rustychris/freebird/firmware/sketches/README.md

Sketches
###

Shell01Teensy: this is the primary firmware running on the Teensy.  This is probably all that you need, with the possible exception
of programming the baud rate/name for the bluetooth.  That's handled by a separate sketch which I've not yet gotten around to
posting.
