rustychris/freebird/hardware/batterypack/pcb_batteries-brd.png

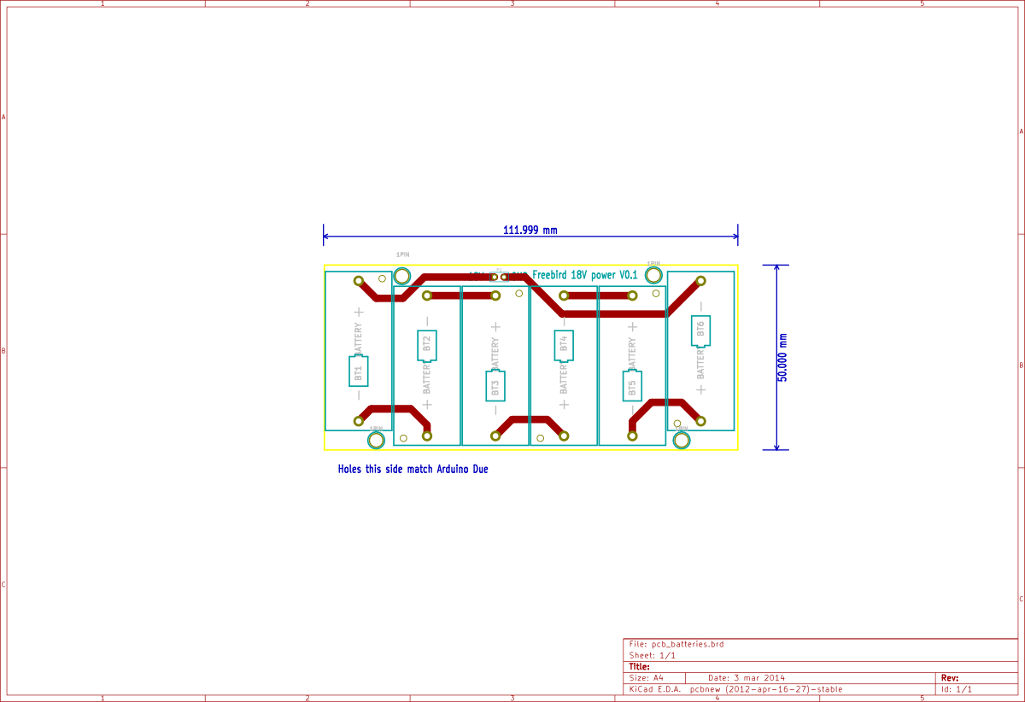
hardware/batterypack/pcb_batteries-brd.png
