rustychris/freebird/hardware/batterypack/pcb_batteries.png

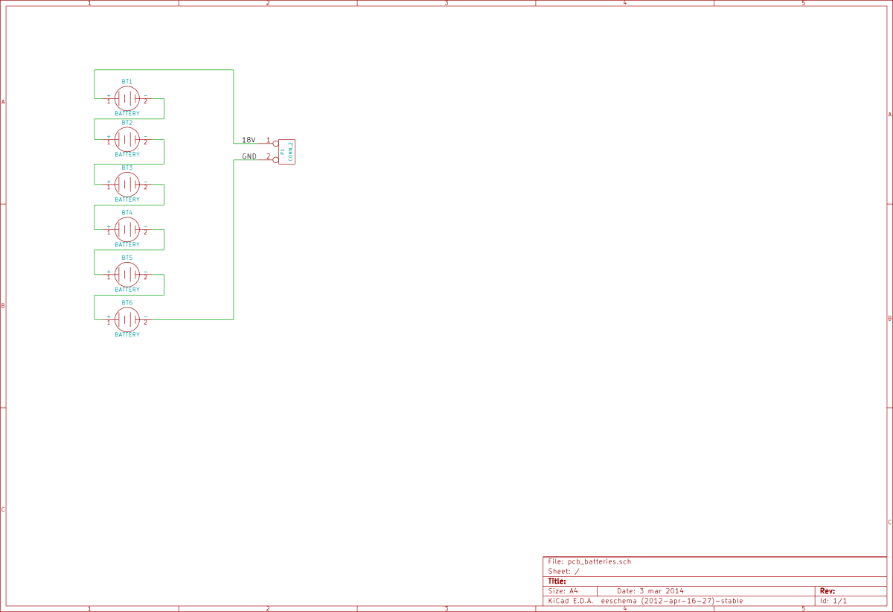
hardware/batterypack/pcb_batteries.png
