rustychris/freebird/hardware/logger/freebird_pcb01-brd.png

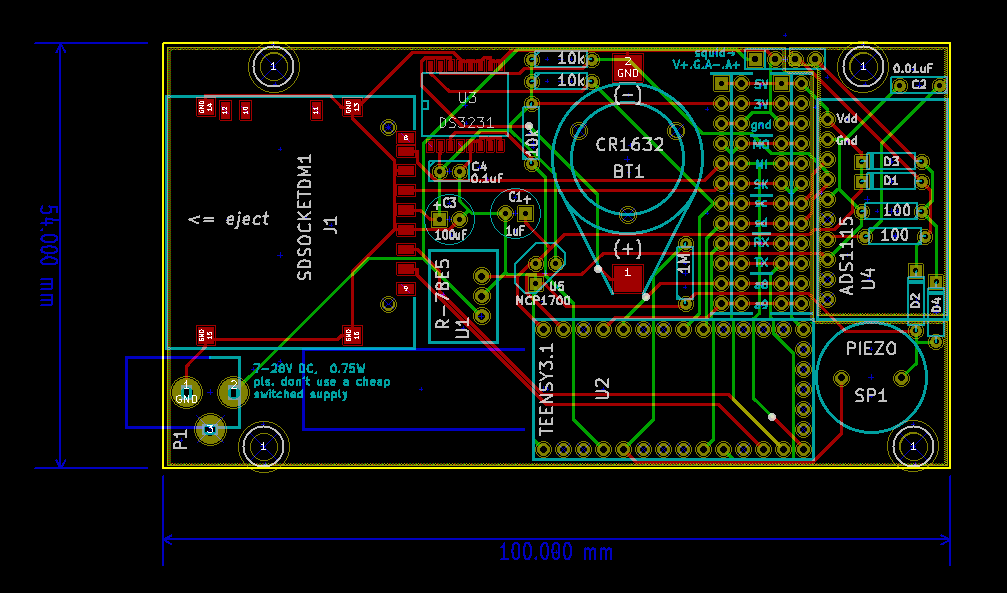
hardware/logger/freebird_pcb01-brd.png
