rustychris/freebird/hardware/logger/freebird_pcb01.png

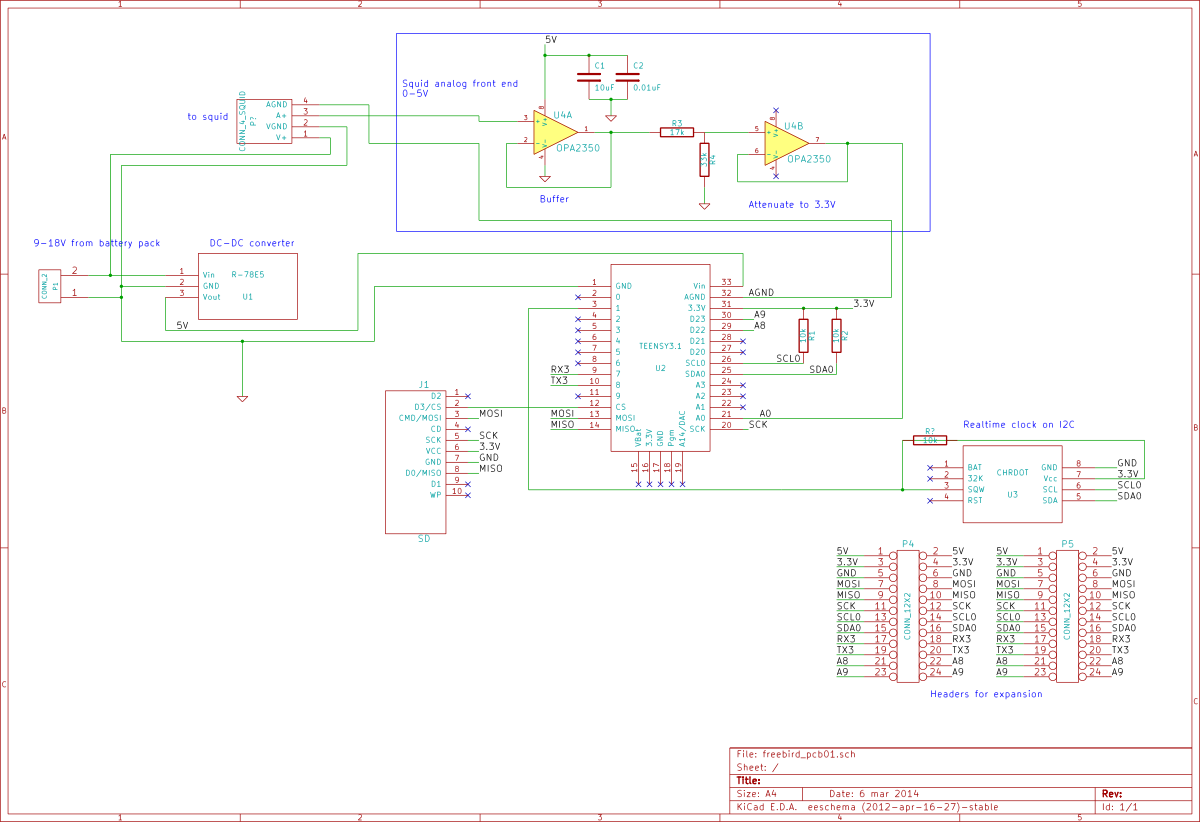
hardware/logger/freebird_pcb01.png
