rustychris/freebird/hardware/logger/freebird_pcb01.pdf

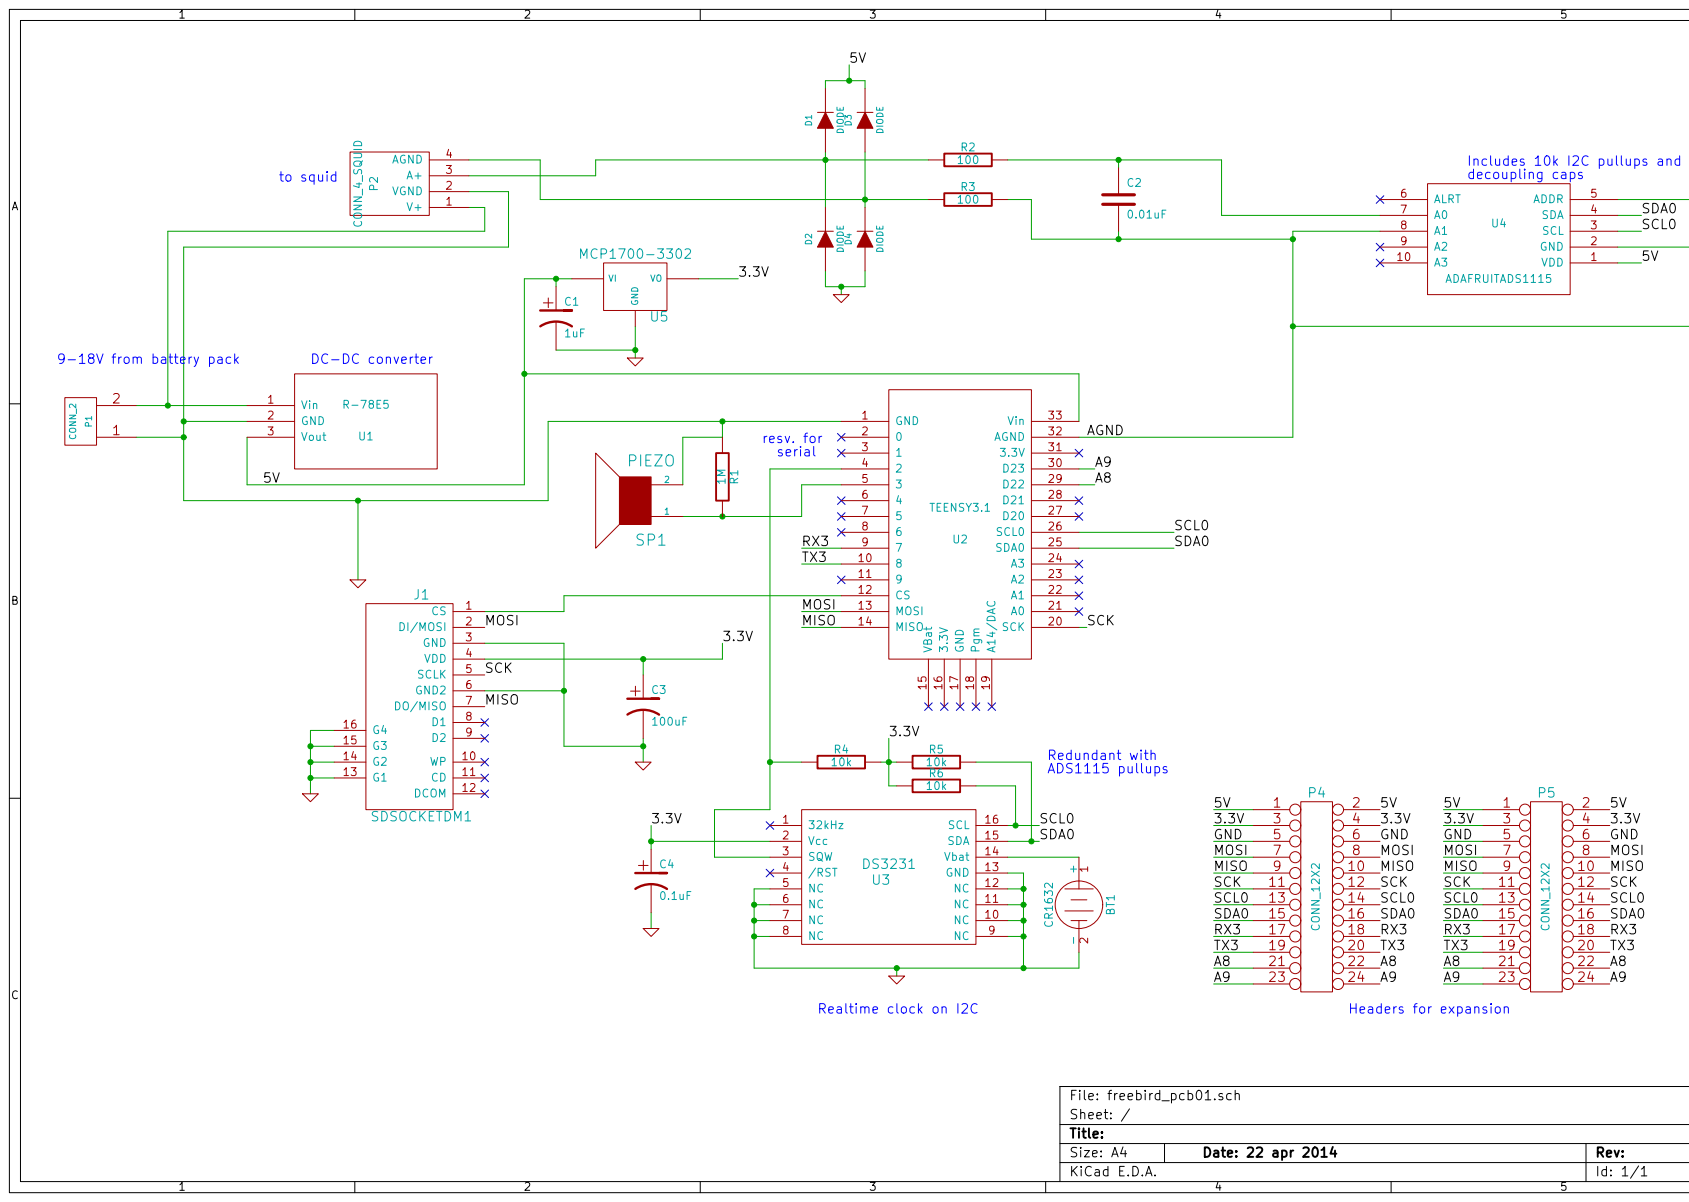
[picture p5: page 1]
