rustychris/freebird/hardware/batterypack/pcb_batteries-brd.pdf

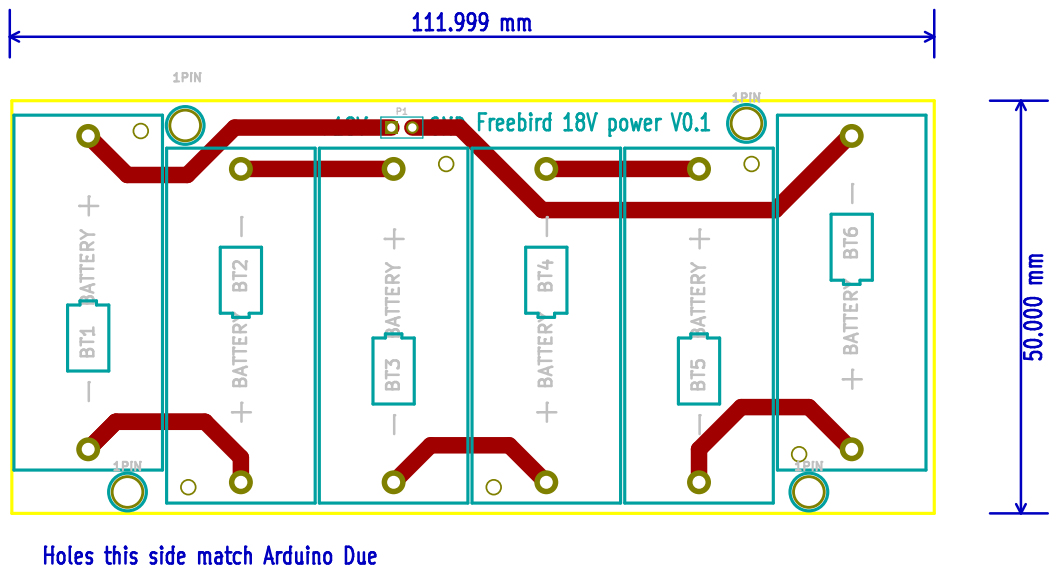
[picture p6: page 1]
