rustychris/freebird/hardware/batterypack/pcb_batteries.pdf

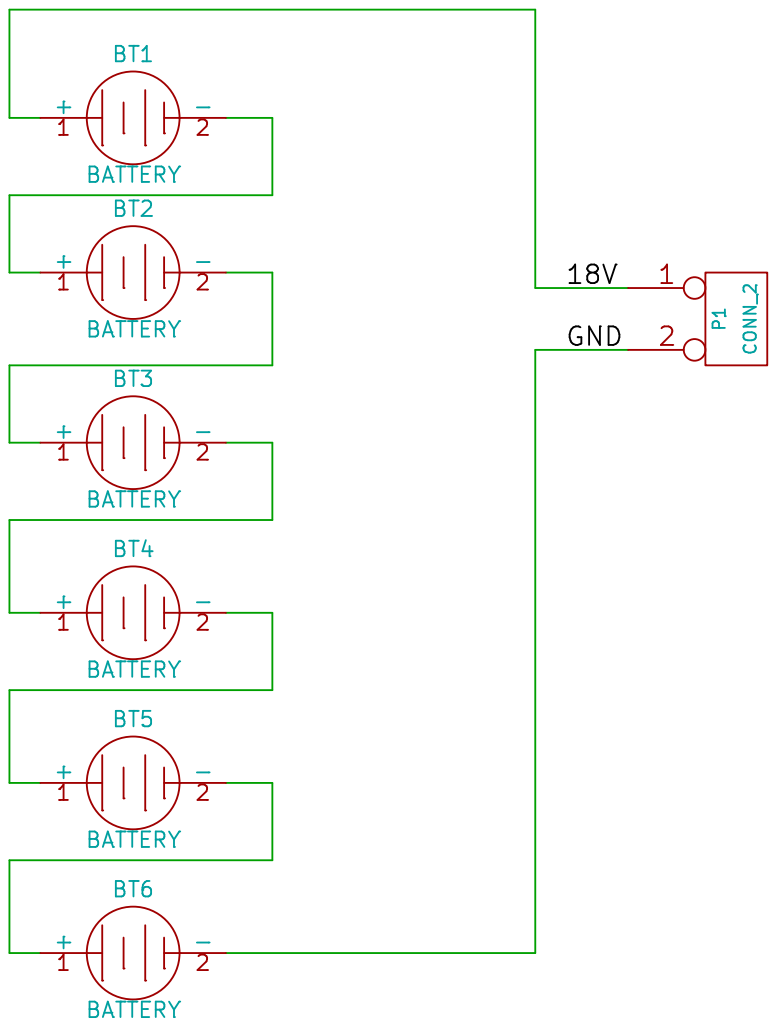
[picture p7: page 1]
