rustychris/freebird/hardware/batterypack/pcb_batteries.sch

## KiCad design hardware/batterypack/pcb_batteries.sch (2014-03-18)

Schematic: pcb_batteries.sch

Parts:
BT1, BT2, BT3, BT4, BT5, BT6: BATTERY
P1: CONN_2
