rustychris/freebird/hardware/logger/freebird_pcb01.sch

## KiCad design hardware/logger/freebird_pcb01.sch (2014-04-23, an earlier design)

Schematic: freebird_pcb01.sch

Parts:
C1: 10uF
C2: 0.01uF
J1: SD
P1: CONN_2
P4, P5: CONN_12X2
R1, R2: 10k
R3: 17k
R4: 33k
U1: R-78E5; MODULE
U2: TEENSY3.1; MODULE
U3: CHRDOT; MODULE
U4: OPA2350

Notes on the sheet:
to squid
DC-DC converter
9-18V from battery pack
Headers for expansion
Realtime clock on I2C
Attenuate to 3.3V
Buffer
Squid analog front end 0-5V
