rustychris/freebird/(commit log)

2014-03-18 checking in from svn repo
    [freebird_pcb01.brd, freebird_pcb01.sch, pcb_batteries.brd, pcb_batteries.sch]
2014-03-18 added raster versions of schematics and boards
2014-03-19 add ADS1115 breakout
    [freebird_pcb01.sch]
2014-03-21 nearing final draft of logger board
    [freebird_pcb01.sch]
2014-03-25 About to try a ground plane, but everything else is ready to go
    [freebird_pcb01.brd, freebird_pcb01.sch]
2014-03-25 about to fix USB access
    [freebird_pcb01.brd, freebird_pcb01.sch]
2014-03-26 Made room for usb cable.
    Shifted modules to allow just enough room for the USB cable to
    be attached to the teensy.
    [freebird_pcb01.brd]
2014-03-26 fixed missing MOSI trace
    [freebird_pcb01.brd]
2014-03-26 Added ground planes, adjust label positions
    Also checked gerber output, renamed plot outputs
    to exactly match Seeeedstudio lists.
    [freebird_pcb01.brd]
2014-03-26 Ready to submit.
    [freebird_pcb01.brd]
2014-04-21 zipfile contents and a fix for adding files to it.
    Fixed a bug in the zipfile which would add files but not
    remove existing files in the zip archive. Also committing
    the renamed contents of the zipfile. Note that this version
    still has a bunch of bugs, to be fixed very soon.
    [freebird_pcb01.gbl, freebird_pcb01.gbo, freebird_pcb01.gbs, freebird_pcb01.gtl, freebird_pcb01.gto, freebird_pcb01.gts]
2014-04-22 Fixes and switch to SMD for SD and RTC
    - this is almost V0.2
    - smaller holes for barrel jack
    - switched to a directly attached SD slot, coin cell holder and DS3231 RTC
    - fixed the SDA/SCL swap from v0.1
    - larger safe area around mounting holes
    - change ESD circuit to put resistors after diodes
    - separate 250mA 3.3V LDO regulator
    - dual decoupling caps for 3.3V line
    - added some space between the expansions header rows
    - cleared out space for easier USB access
    [freebird_pcb01.brd, freebird_pcb01.sch]
2014-04-22 v0.2 sent to fab
    minor rearranging, relabeling, etc.
    [freebird_pcb01.brd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]
2014-04-29 Progress in new file format, more GUI functionality
    But firmward updates put this behind the current format.
2014-05-01 Deemphasis, calibration code.
    Basic deemphasis, and a rough framework for collecting
    calibration information.
2014-05-02 GUI doesn't exit sample mode
    GUI now has a distinction between command mode and sample mode,
    and device can query for one or the other.
    [device.py, gui.py]
2014-05-08 Numerous. Better BT, error checks, GUI interaction, etc.
    Fixed some issues with slow serial connections like bluetooth.
    [device.py, gui.py]
2014-05-12 Basic compass calibration GUI.
2014-05-20 Magnetometer and gyro calibrations.
2014-07-01 Various parsing and IMU speedups
2014-07-01 Adding Arduino code and libraries to git repo
2014-07-10 Updated pdf/png of schematic/board.
    No changes to board, just updated the plots for the webpage.
2014-09-02 Towards processing smart subset of IMU data
2014-09-02 Replotted the board
2015-03-09 Missing SD is nonfatal, but beeps error code
    This allows setting the clock and checking the rest of the
    system without an SD card.
    [SdFunctions.h, logger.cpp, logger.h]
2015-03-09 Cast to double to avoid integer math problems
    [madgwick.py]
2015-03-18 Initial checkin of basic matlab code
    Code for parsing binary files and setting clock. N.B. clock
    setting is cumbersome on OSX because Matlab defaults to
    a restrictive filename pattern for serial devices.
2015-08-18 Including sample command file for basic operation.
